JamesM92/SumoBot_2022Fall-ME4543-OC1/README.md

# SumoBot_2022Fall-ME4543-OC1
group design project sumobot for mechatronics
