JamesM92/SumoBot_2022Fall-ME4543-OC1/PCB/SumoBotPCB/SumoBotPCB.step

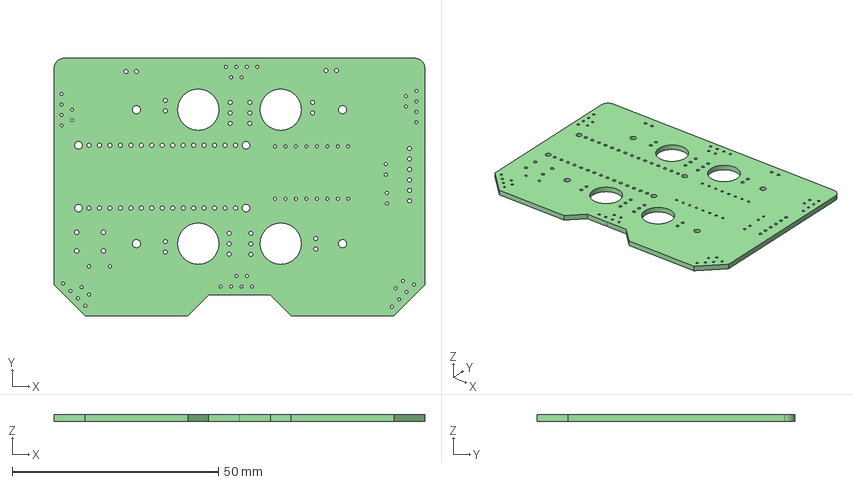
[picture p1: CAD file, 2022-11-03]
PCB/SumoBotPCB/SumoBotPCB.step
90.0 x 62.5 x 1.60 mm
