JamesM92/SumoBot_2022Fall-ME4543-OC1/PCB/SumoBotPCB/Layers.pdf

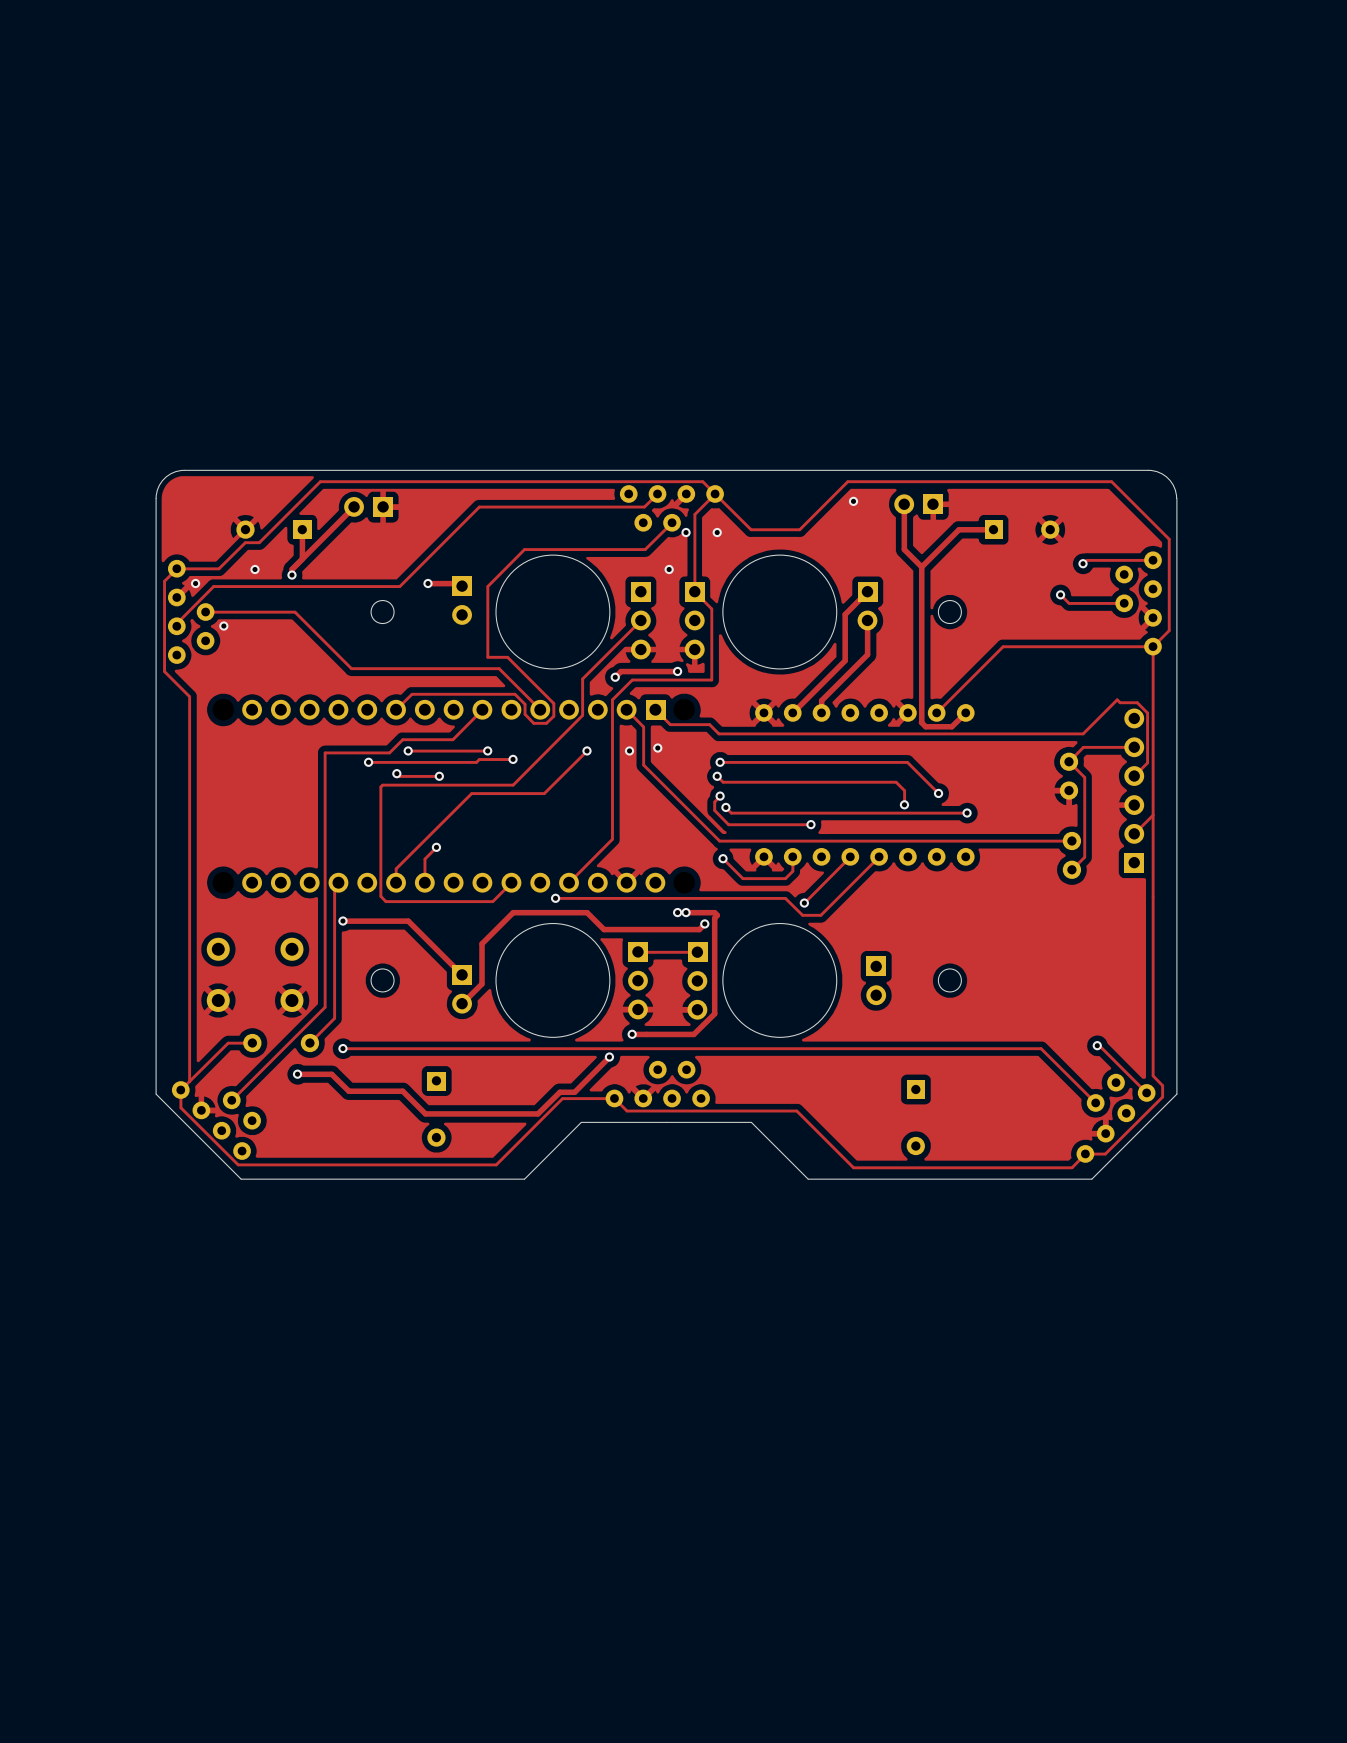
[picture p2: page 1]

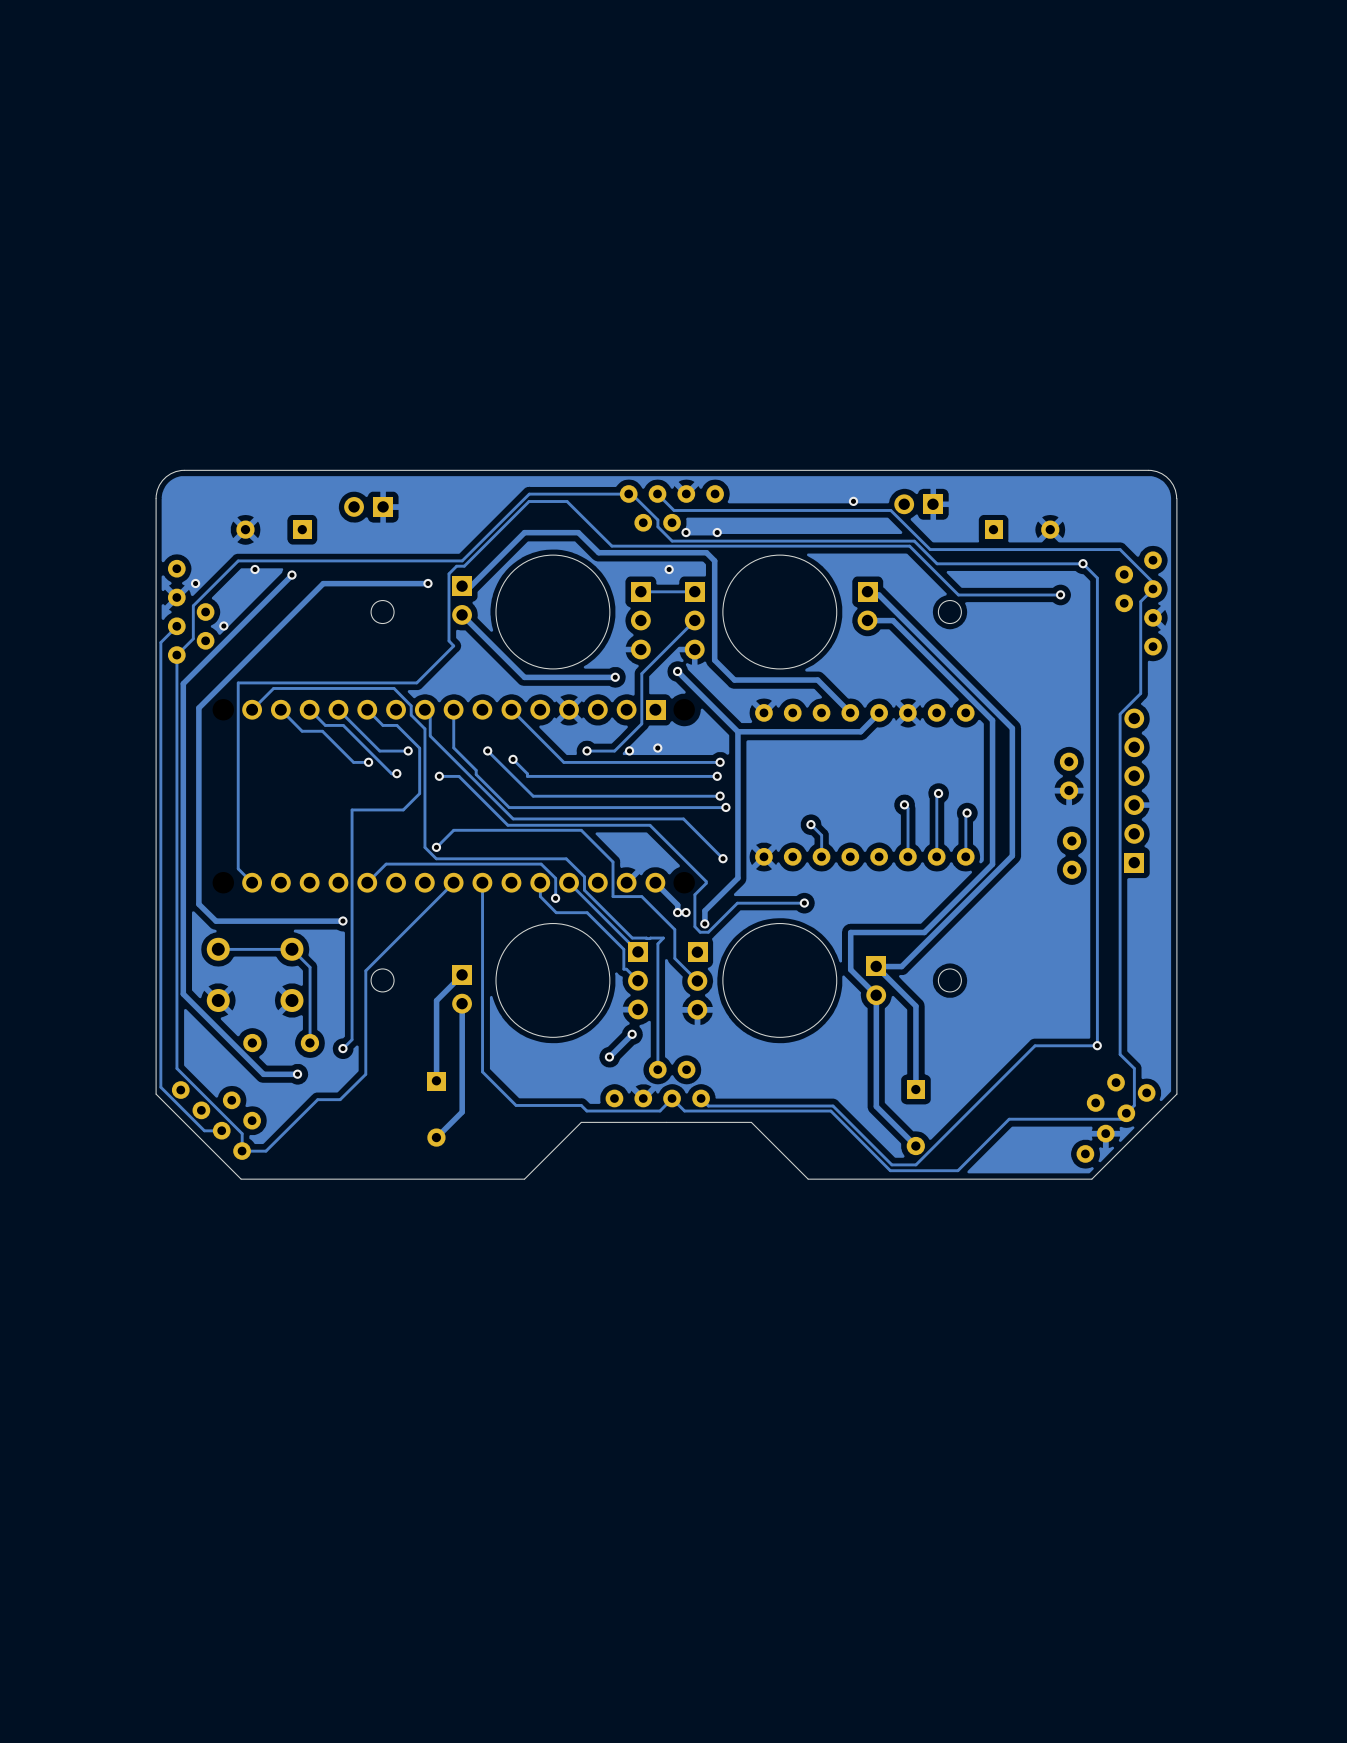
[picture p3: page 2]

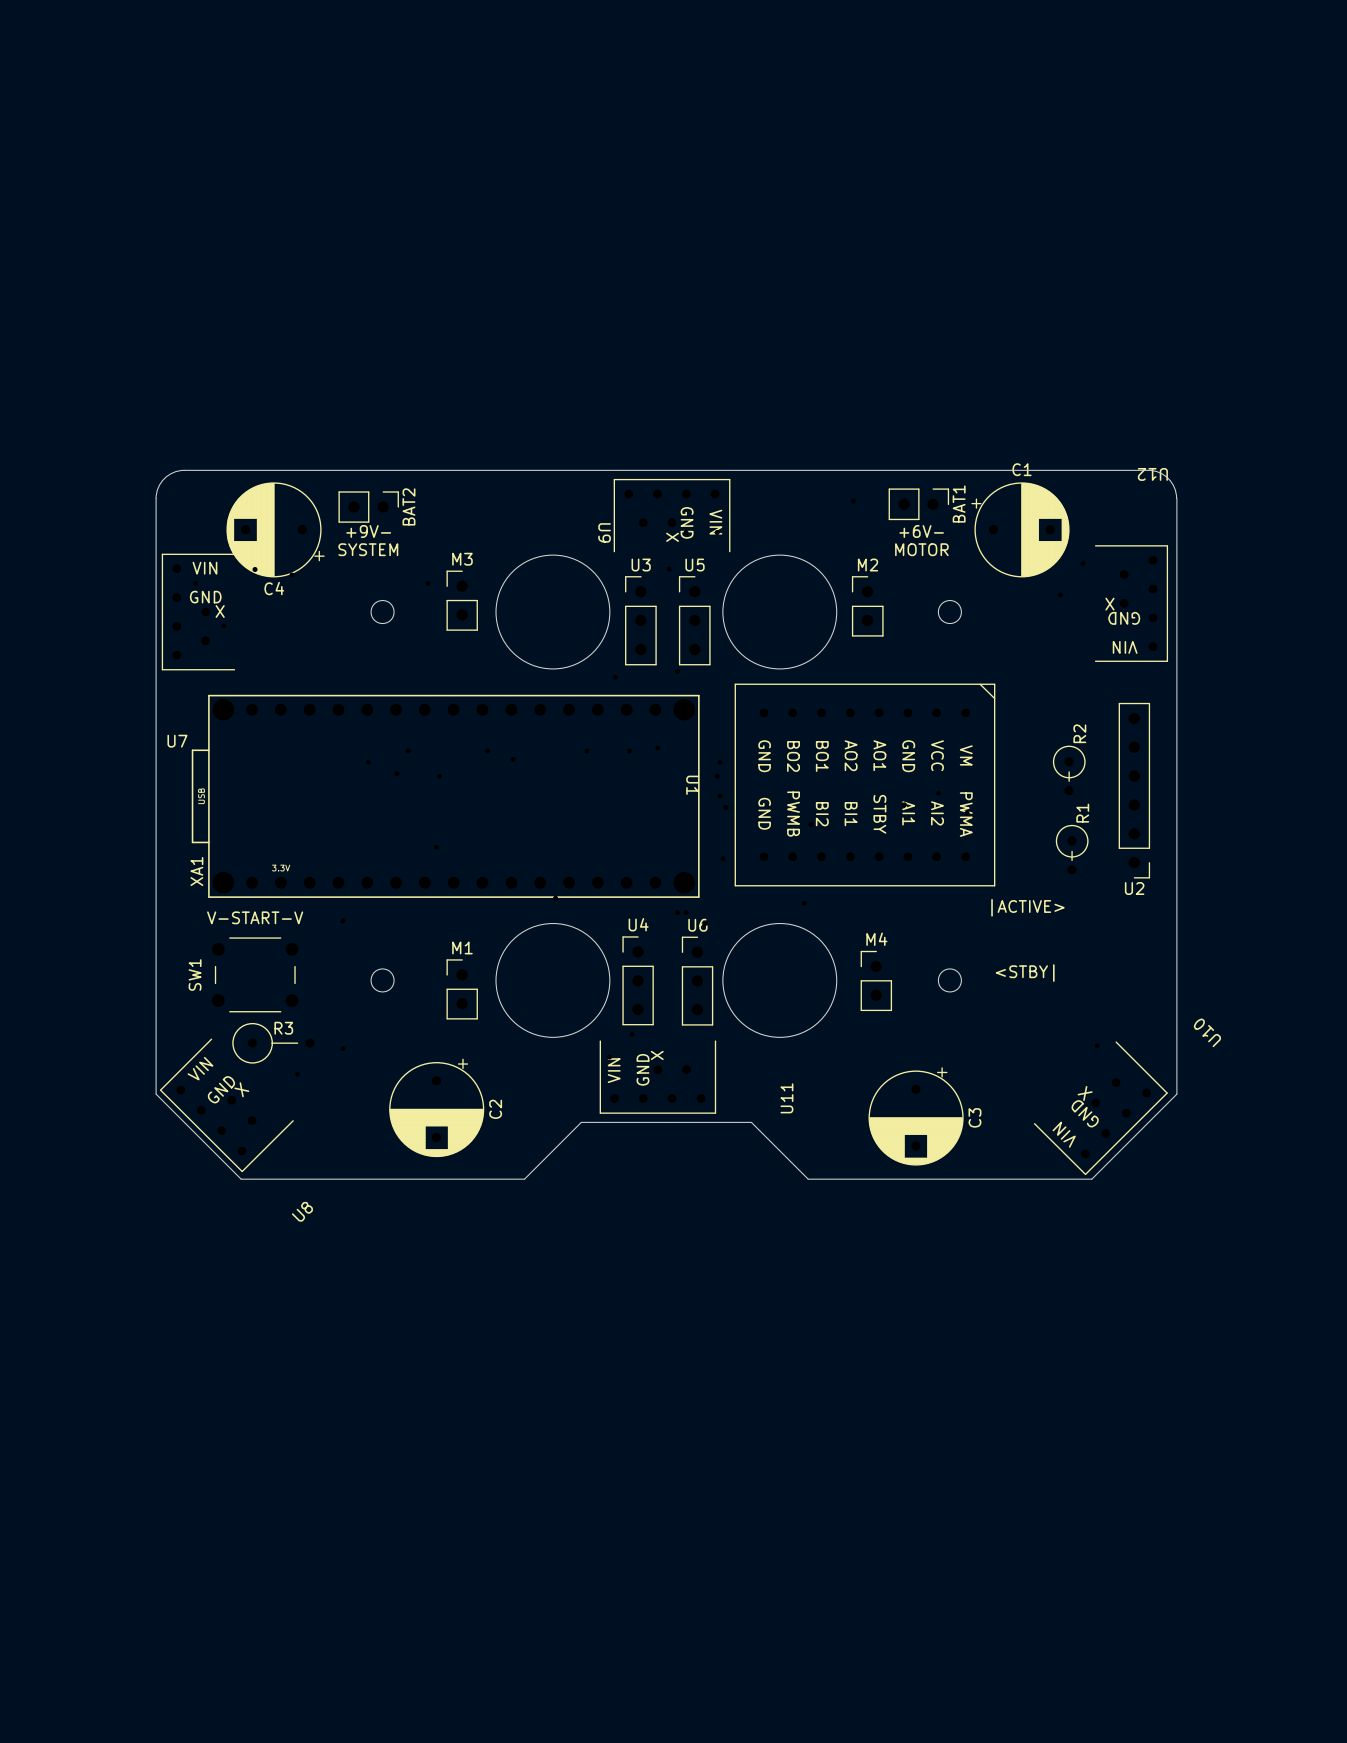
[picture p4: page 3]

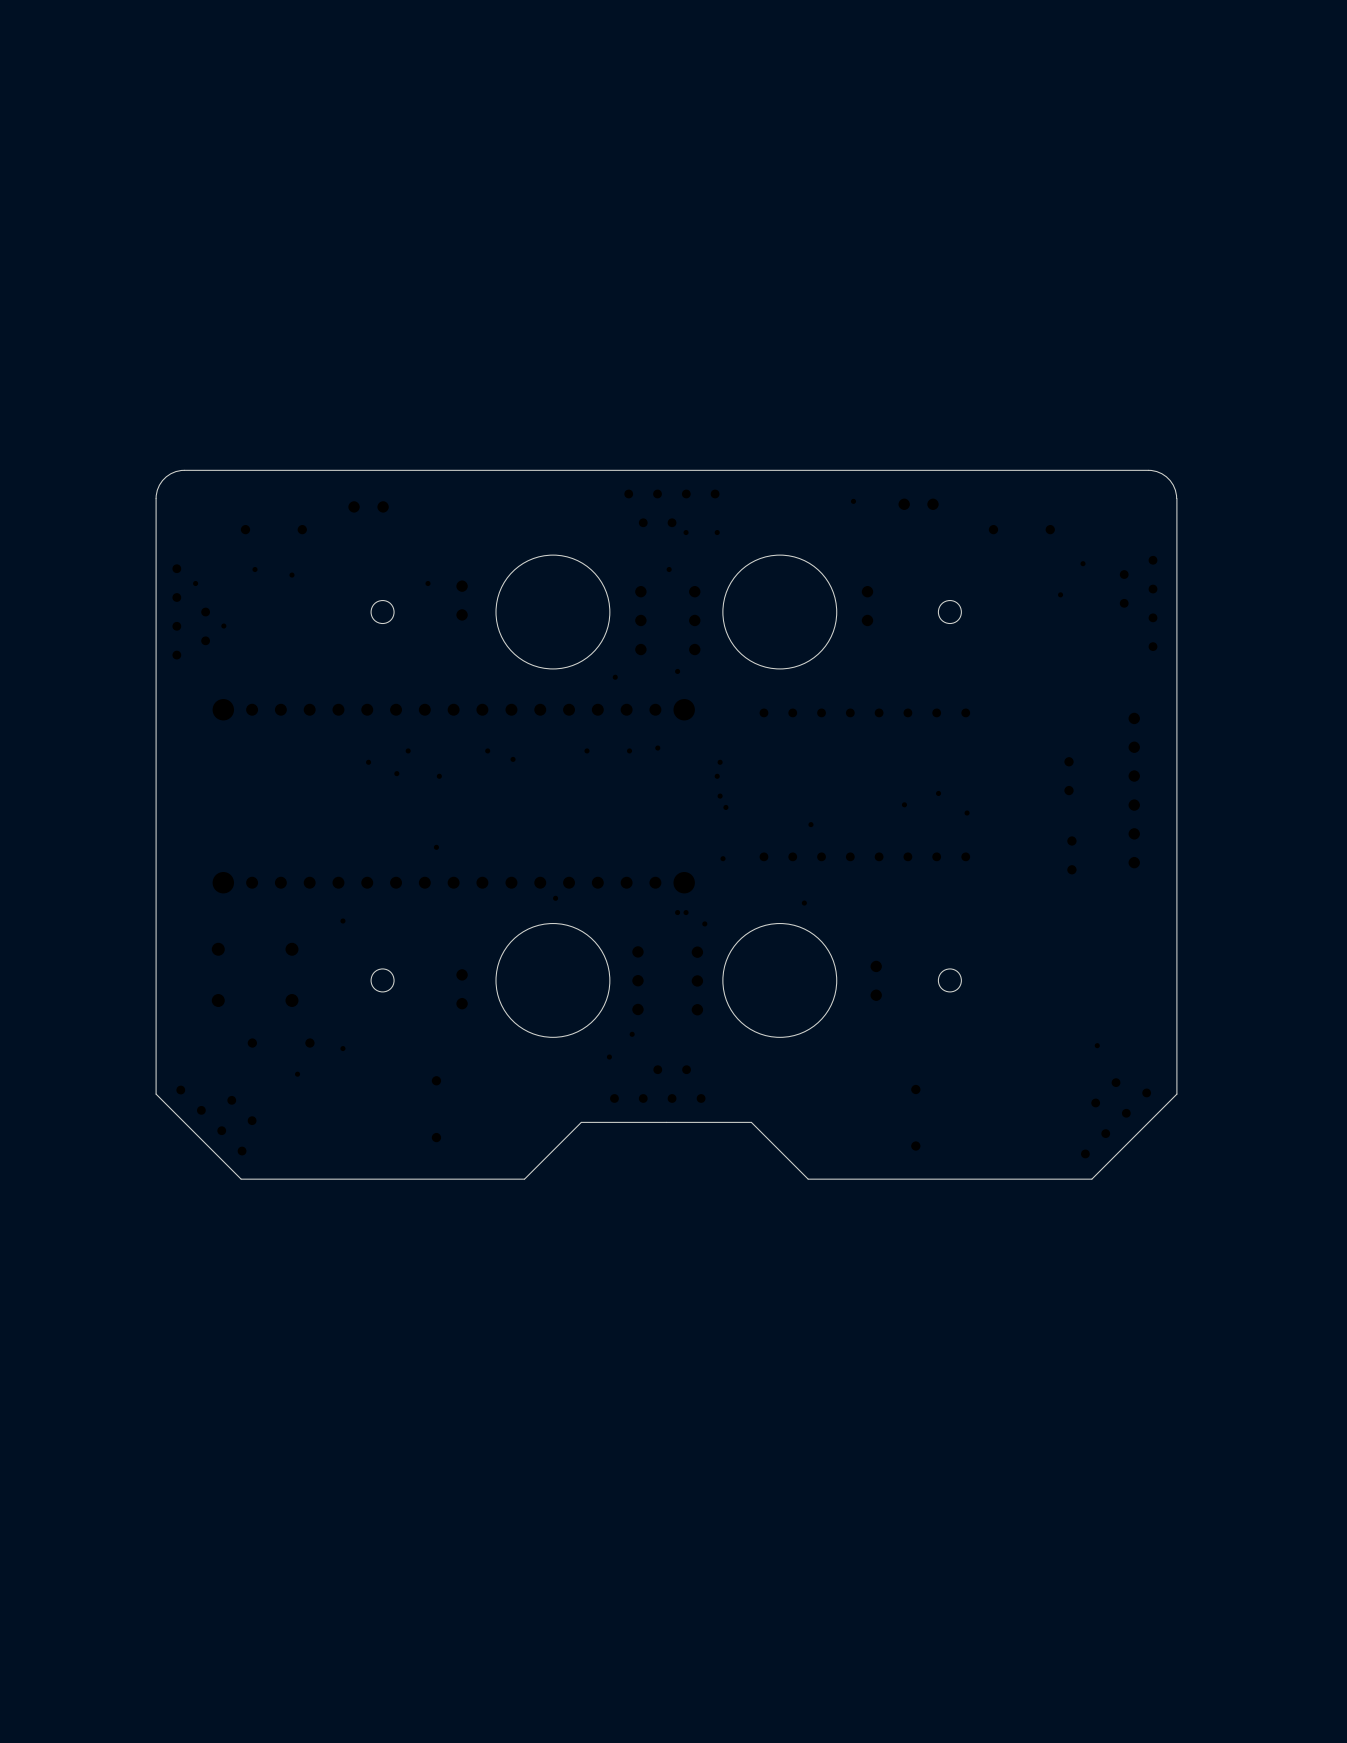
[picture p5: page 4]
