JamesM92/SumoBot_2022Fall-ME4543-OC1/PCB/SumoBotPCB/SumoBotPCB.kicad_pcb

## KiCad design PCB/SumoBotPCB/SumoBotPCB.kicad_pcb (2022-12-02)

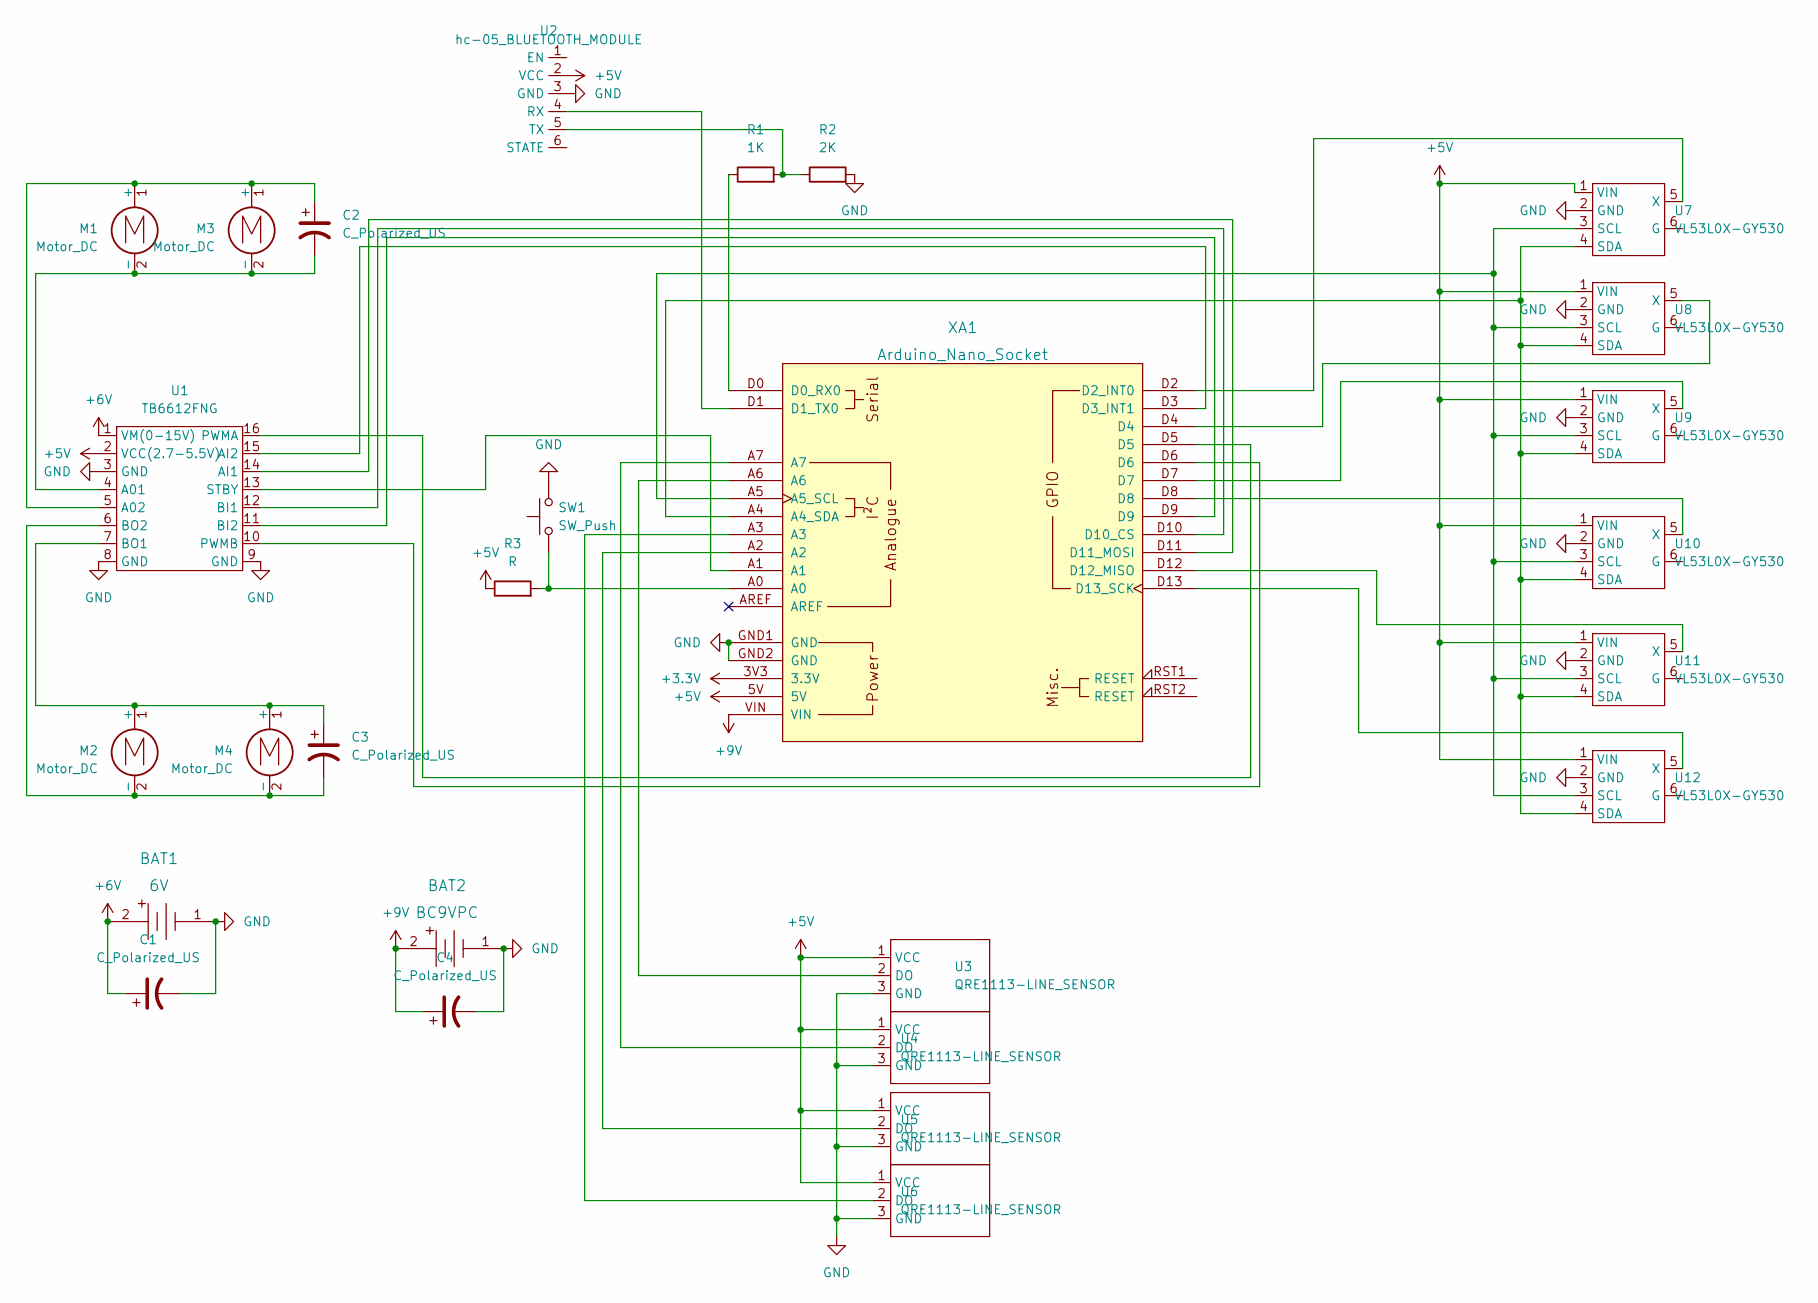
[picture p6: schematic SumoBotPCB.kicad_sch]

Parts:
BAT1: 6V; PinHeader_1x02_P2.54mm_Vertical; MPN BC9VPC; Digi-Key_PN BC9VPC-ND
BAT2: BC9VPC; PinHeader_1x02_P2.54mm_Vertical; MPN BC9VPC; Digi-Key_PN BC9VPC-ND
C1, C2, C3, C4: C_Polarized_US; CP_Radial_D8.0mm_P5.00mm
M1, M2, M3, M4: Motor_DC; PinHeader_1x02_P2.54mm_Vertical
R1: 1K; R_Axial_DIN0207_L6.3mm_D2.5mm_P2.54mm_Vertical
R2: 2K; R_Axial_DIN0207_L6.3mm_D2.5mm_P2.54mm_Vertical
R3: R; R_Axial_DIN0309_L9.0mm_D3.2mm_P5.08mm_Vertical
SW1: SW_Push; SW_PUSH_6mm_H4.3mm
U1: TB6612FNG; tb6612fng
U2: hc-05_BLUETOOTH_MODULE; PinHeader_1x06_P2.54mm_Vertical
U3, U4, U5, U6: QRE1113-LINE_SENSOR; PinHeader_1x03_P2.54mm_Vertical
U7, U8, U9, U10, U11, U12: VL53L0X-GY530
XA1: Arduino_Nano_Socket

Connections:
+3.3V: XA1.3V3 (3.3V)
+5V: R3.1, U1.2 (VCC(2.7-5.5V)), U2.2 (VCC), U3.1 (VCC), U4.1 (VCC), U5.1 (VCC), U6.1 (VCC), U7.1 (VIN), U8.1 (VIN), U9.1 (VIN), U10.1 (VIN), U11.1 (VIN), U12.1 (VIN), XA1.5V
+6V: BAT1.2, C1.1, U1.1 (VM(0-15V))
+9V: BAT2.2, C4.1, XA1.VIN
GND: BAT1.1, BAT2.1, C1.2, C4.2, R2.2, SW1.2, U1.3 (GND), U1.8 (GND), U1.9 (GND), U2.3 (GND), U3.3 (GND), U4.3 (GND), U5.3 (GND), U6.3 (GND), U7.2 (GND), U8.2 (GND), U9.2 (GND), U10.2 (GND), U11.2 (GND), U12.2 (GND), XA1.GND1 (GND), XA1.GND2 (GND)
unnamed: C2.1, M1.1 (+), M3.1 (+), U1.5 (A02)
unnamed: C2.2, M1.2 (-), M3.2 (-), U1.4 (A01)
unnamed: C3.1, M2.1 (+), M4.1 (+), U1.7 (BO1)
unnamed: C3.2, M2.2 (-), M4.2 (-), U1.6 (BO2)
unnamed: R1.1, XA1.D0 (D0_RX0)
unnamed: R1.2, R2.1, U2.5 (TX)
unnamed: U1.11 (BI2), XA1.D9
unnamed: U1.14 (AI1), XA1.D11 (D11_MOSI)
unnamed: U2.4 (RX), XA1.D1 (D1_TX0)
unnamed: U3.2 (DO), XA1.A6
unnamed: U4.2 (DO), XA1.A7
unnamed: U5.2 (DO), XA1.A2
unnamed: U6.2 (DO), XA1.A3
unnamed: U7.3 (SCL), U8.3 (SCL), U9.3 (SCL), U10.3 (SCL), U11.3 (SCL), U12.3 (SCL), XA1.A5 (A5_SCL)
unnamed: U7.4 (SDA), U8.4 (SDA), U9.4 (SDA), U10.4 (SDA), U11.4 (SDA), U12.4 (SDA), XA1.A4 (A4_SDA)
unnamed: U10.5 (X), XA1.D8
unnamed: U11.5 (X), XA1.D12 (D12_MISO)
unnamed: U12.5 (X), XA1.D13 (D13_SCK)
unnamed: R3.2, SW1.1, XA1.A0
unnamed: U1.13 (STBY), XA1.A1
unnamed: U7.5 (X), XA1.D2 (D2_INT0)
unnamed: U1.15 (AI2), XA1.D3 (D3_INT1)
unnamed: U8.5 (X), XA1.D4
unnamed: U1.16 (PWMA), XA1.D5
unnamed: U1.10 (PWMB), XA1.D6
unnamed: U9.5 (X), XA1.D7
unnamed: U1.12 (BI1), XA1.D10 (D10_CS)

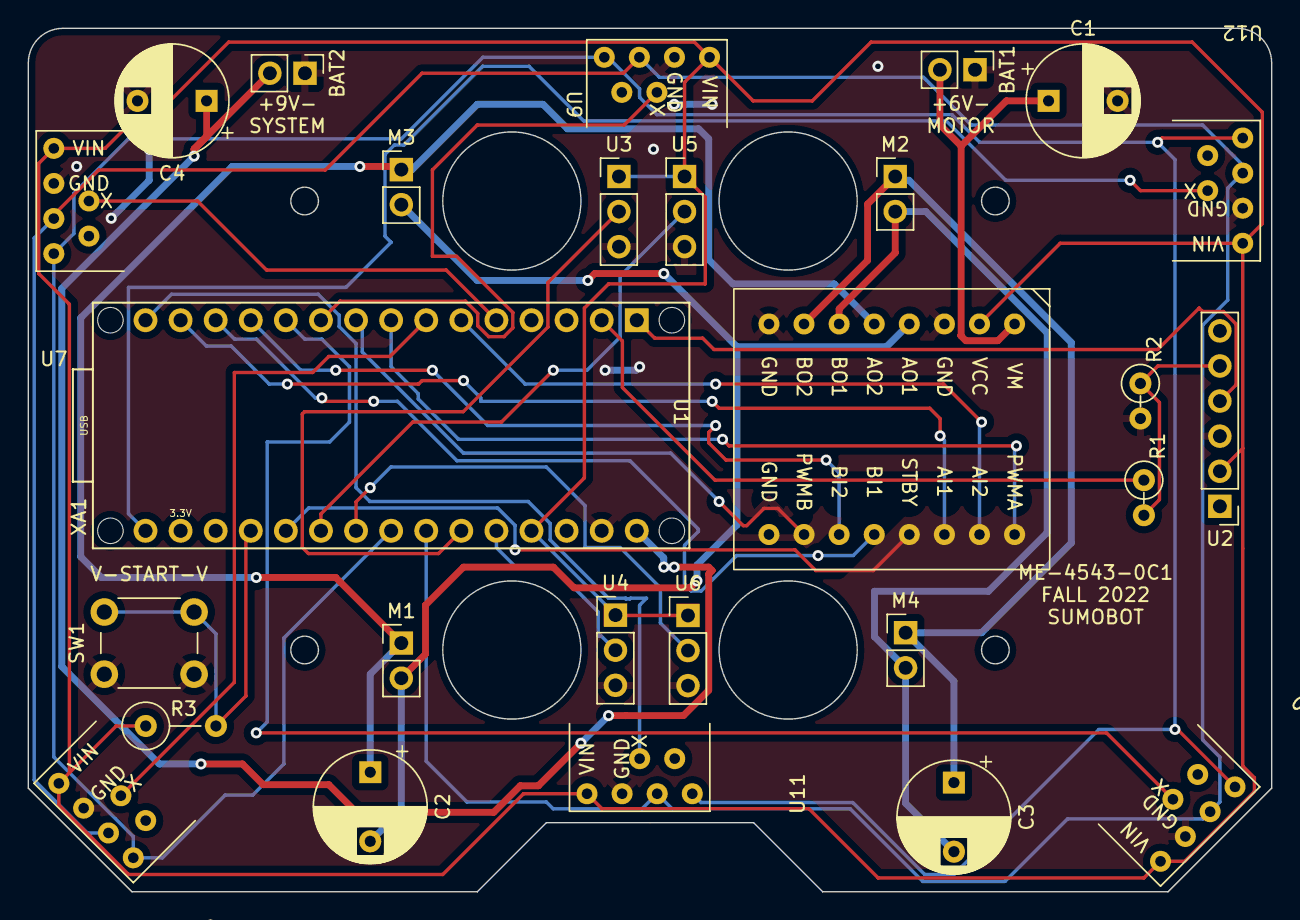
[picture p7: board SumoBotPCB.kicad_pcb from above]

Board: 2 copper layers, 90.0 x 62.5 mm, 27 parts (0 on the bottom side), 31 nets.
