JamesM92/SumoBot_2022Fall-ME4543-OC1/Code/reference/sumobot_V10/include/mouse.h

/**
 * @file mouse.h
 * @author M. Good
 * @brief MOUSE SENSOR (KA2.B PS2 Mouse Sensor similar to A2633)
 * @version 0.1
 * @date 2022-06-20
 * 
 * @copyright Copyright (c) 2022
 */
#ifndef MOUSE_h
#define MOUSE_h

void mouse_setup(void);
void mouse_report(void);

#endif
