JamesM92/SumoBot_2022Fall-ME4543-OC1/Code/Sumobot/test.h

/**
 * @file test.h
 * @author M. Good
 * @brief 
 * @version 0.1
 * @date 2022-06-25
 * 
 * @copyright Copyright (c) 2022
 * 
 */
#ifndef TEST_h
#define TEST_h

long readVcc(void);

void test_ls(void);
void test_ds(void);
void test_motors(void);
#endif
