JamesM92/SumoBot_2022Fall-ME4543-OC1/(commit log)

2022-10-31 main commit of pcb files
    [SumoBotPCB.kicad_pcb, SumoBotPCB.kicad_sch, bom.csv, designators.csv, positions.csv]
2022-11-03 added example code
    added reference example code for project
    [SumoBotPCB.step]
2022-11-04 motor driver pwm
    correct pin assignment to have motor driver use 6 pwm pins to allow all options.
    [SumoBotPCB.kicad_pcb, SumoBotPCB.kicad_sch, bom.csv, designators.csv, positions.csv]
2022-11-04 ADDED STANDBY SWITCH
    [SumoBotPCB.kicad_pcb, SumoBotPCB.kicad_sch]
2022-11-04 re-assigned pins
    changed pin assignments on analog pins
    [SumoBotPCB.kicad_pcb, SumoBotPCB.kicad_sch]
2022-11-04 pwm groups change
    d5 and d6 pwm operate at a different frequency than the rest
    [SumoBotPCB.kicad_pcb]
2022-11-04 cleaned up schematic
    [SumoBotPCB.kicad_sch]
2022-11-04 minor schemtic cleanup
    [SumoBotPCB.kicad_sch]
2022-12-02 corrected driver foot print, add code
    corrected footpring of motor driver from being 0.5" to 0.6" and added the finalized code that works with arduino ide.
    [SumoBotPCB.kicad_pcb, SumoBotPCB.kicad_sch, bom.csv, designators.csv, positions.csv]
